charclo/esc-power-epc/frost-esc.stl

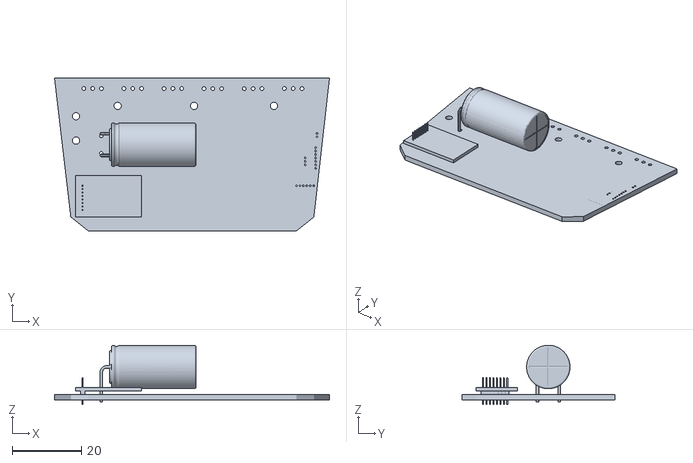
[picture p1: CAD file, 2022-11-25]
frost-esc.stl
79.2 x 44.0 x 17.1
