charclo/esc-power-epc/images/ESC-power-epc.pdf

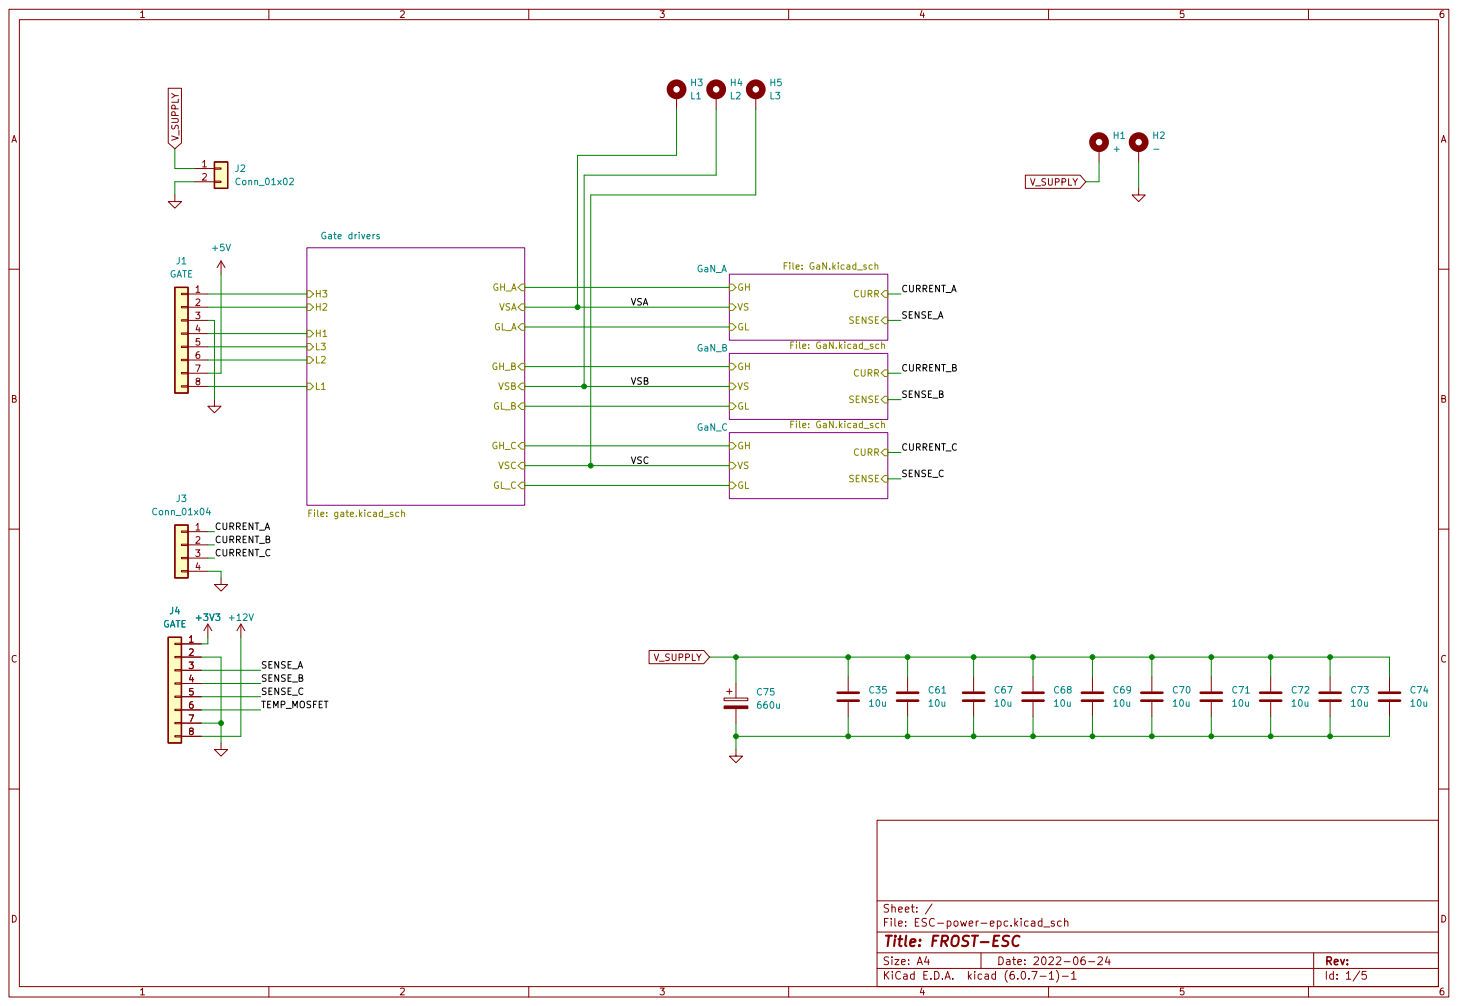
[picture p2: page 1]

VSA

File: ESC-power-epc.kicad_sch Sheet: /
Id: 1/5 Title: FROST-ESC

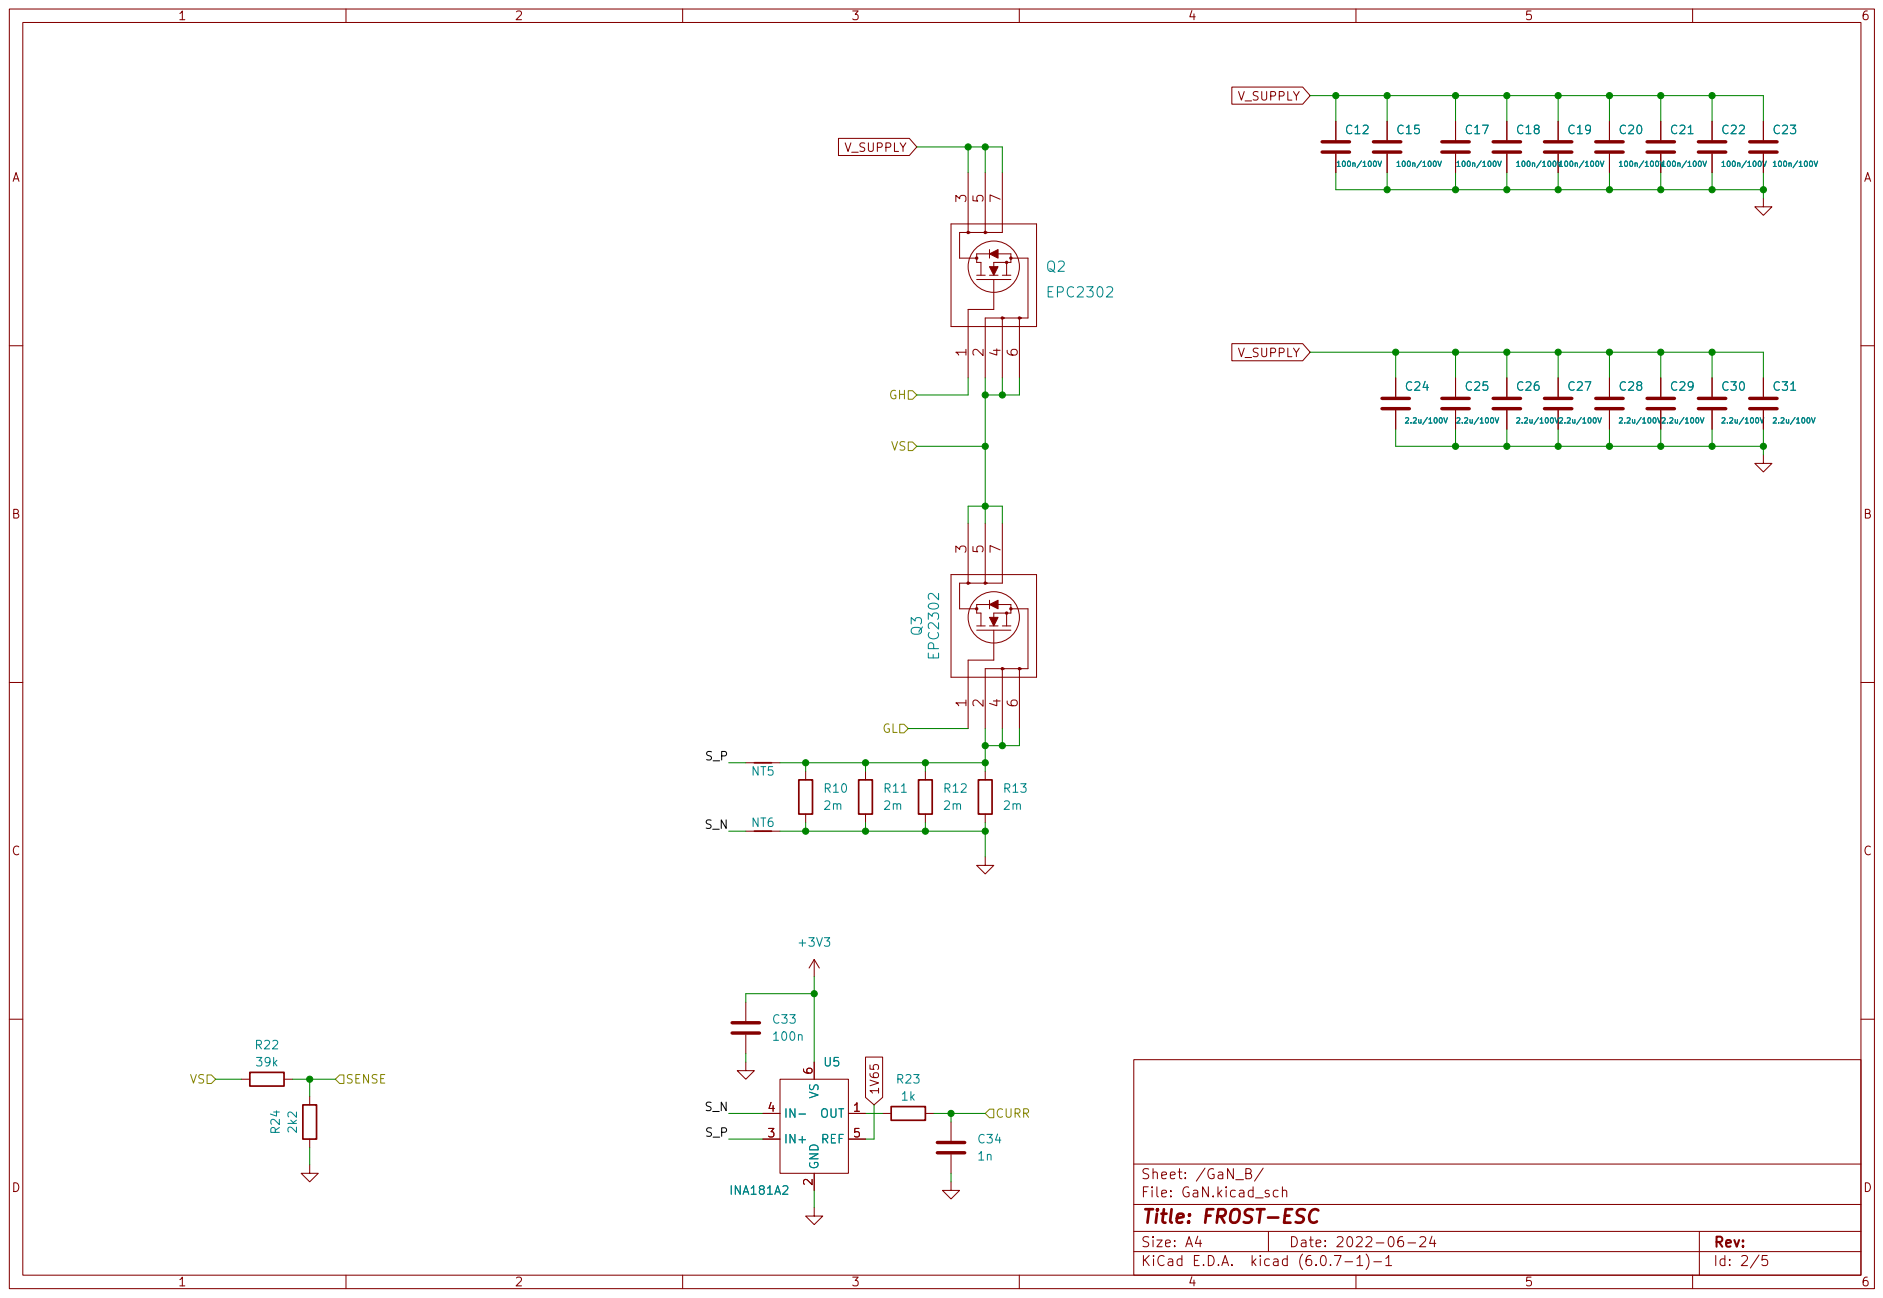
[picture p3: page 2]

File: GaN.kicad_sch
Id: 2/5 Title: FROST-ESC

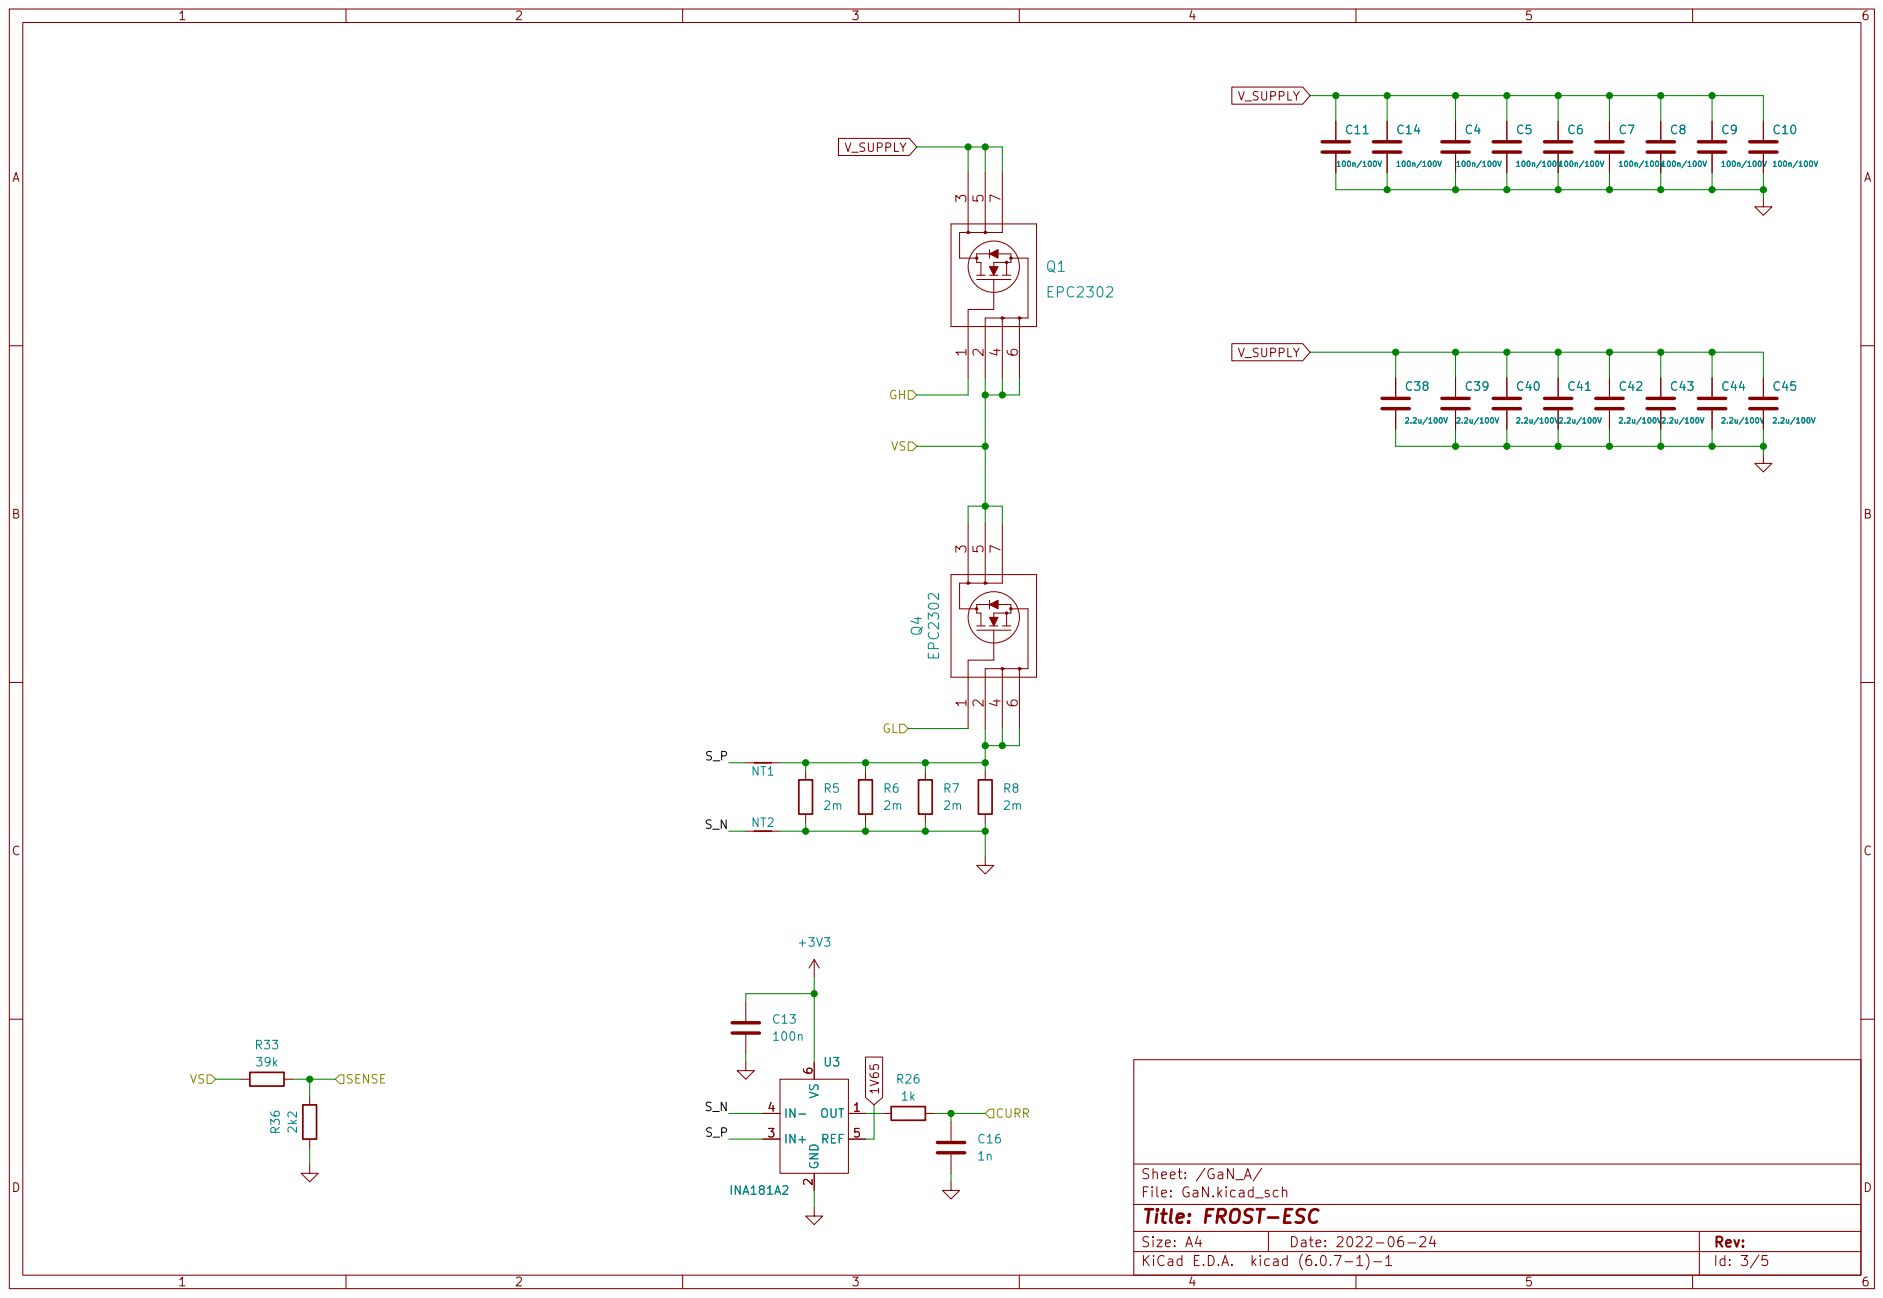
[picture p4: page 3]

File: GaN.kicad_sch
Id: 3/5 Title: FROST-ESC

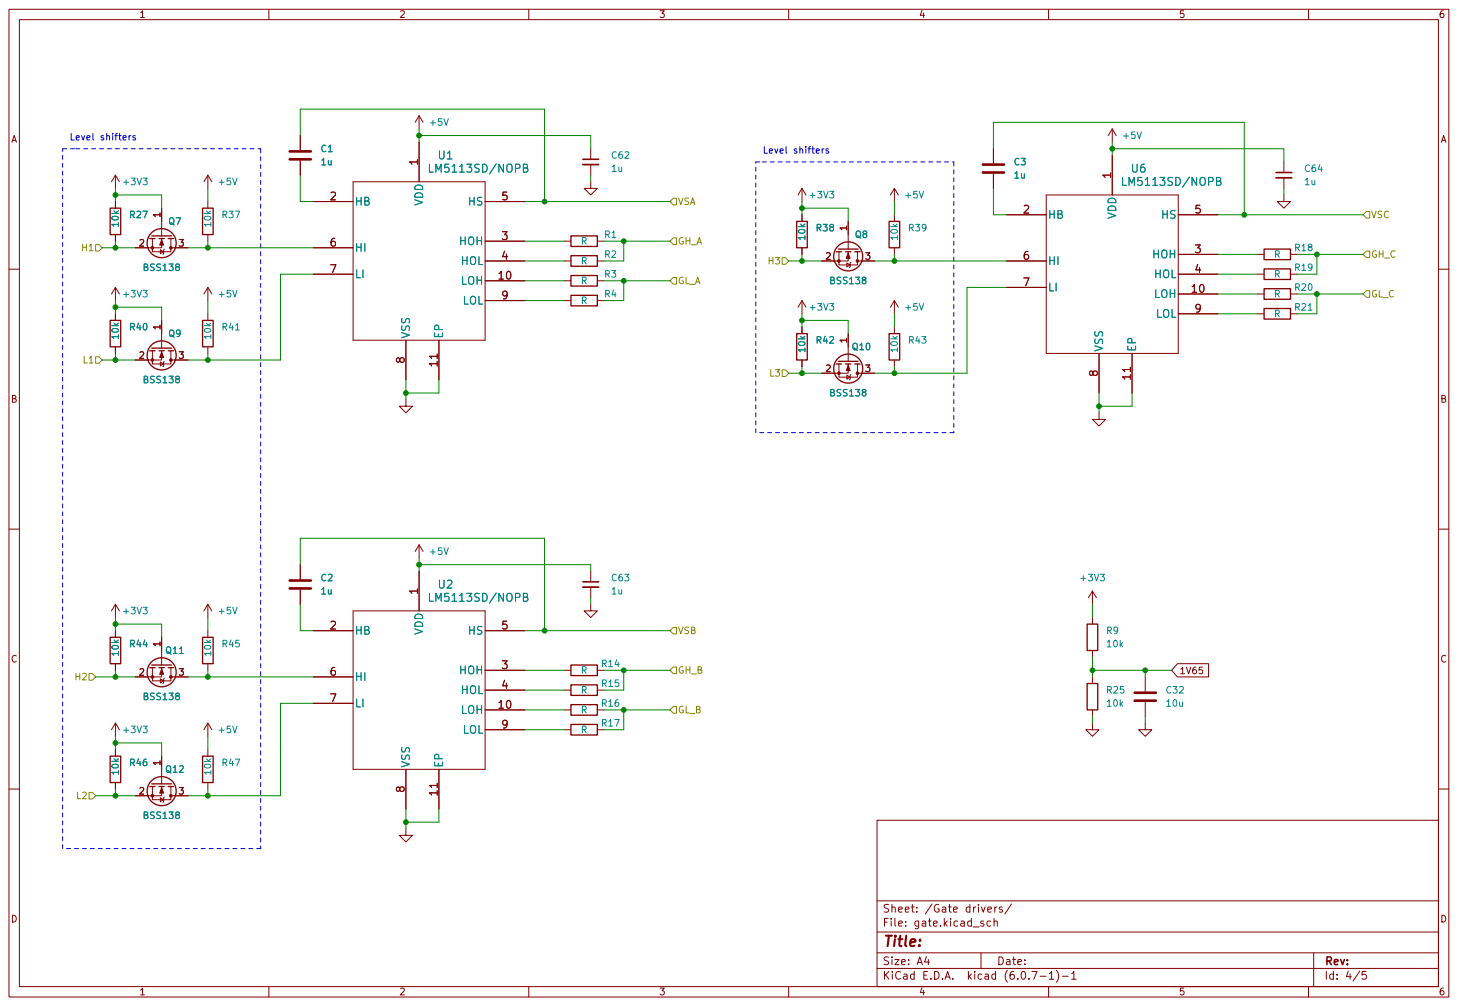
[picture p5: page 4]

File: gate.kicad_sch Sheet: /Gate drivers/
Id: 4/5 Title:

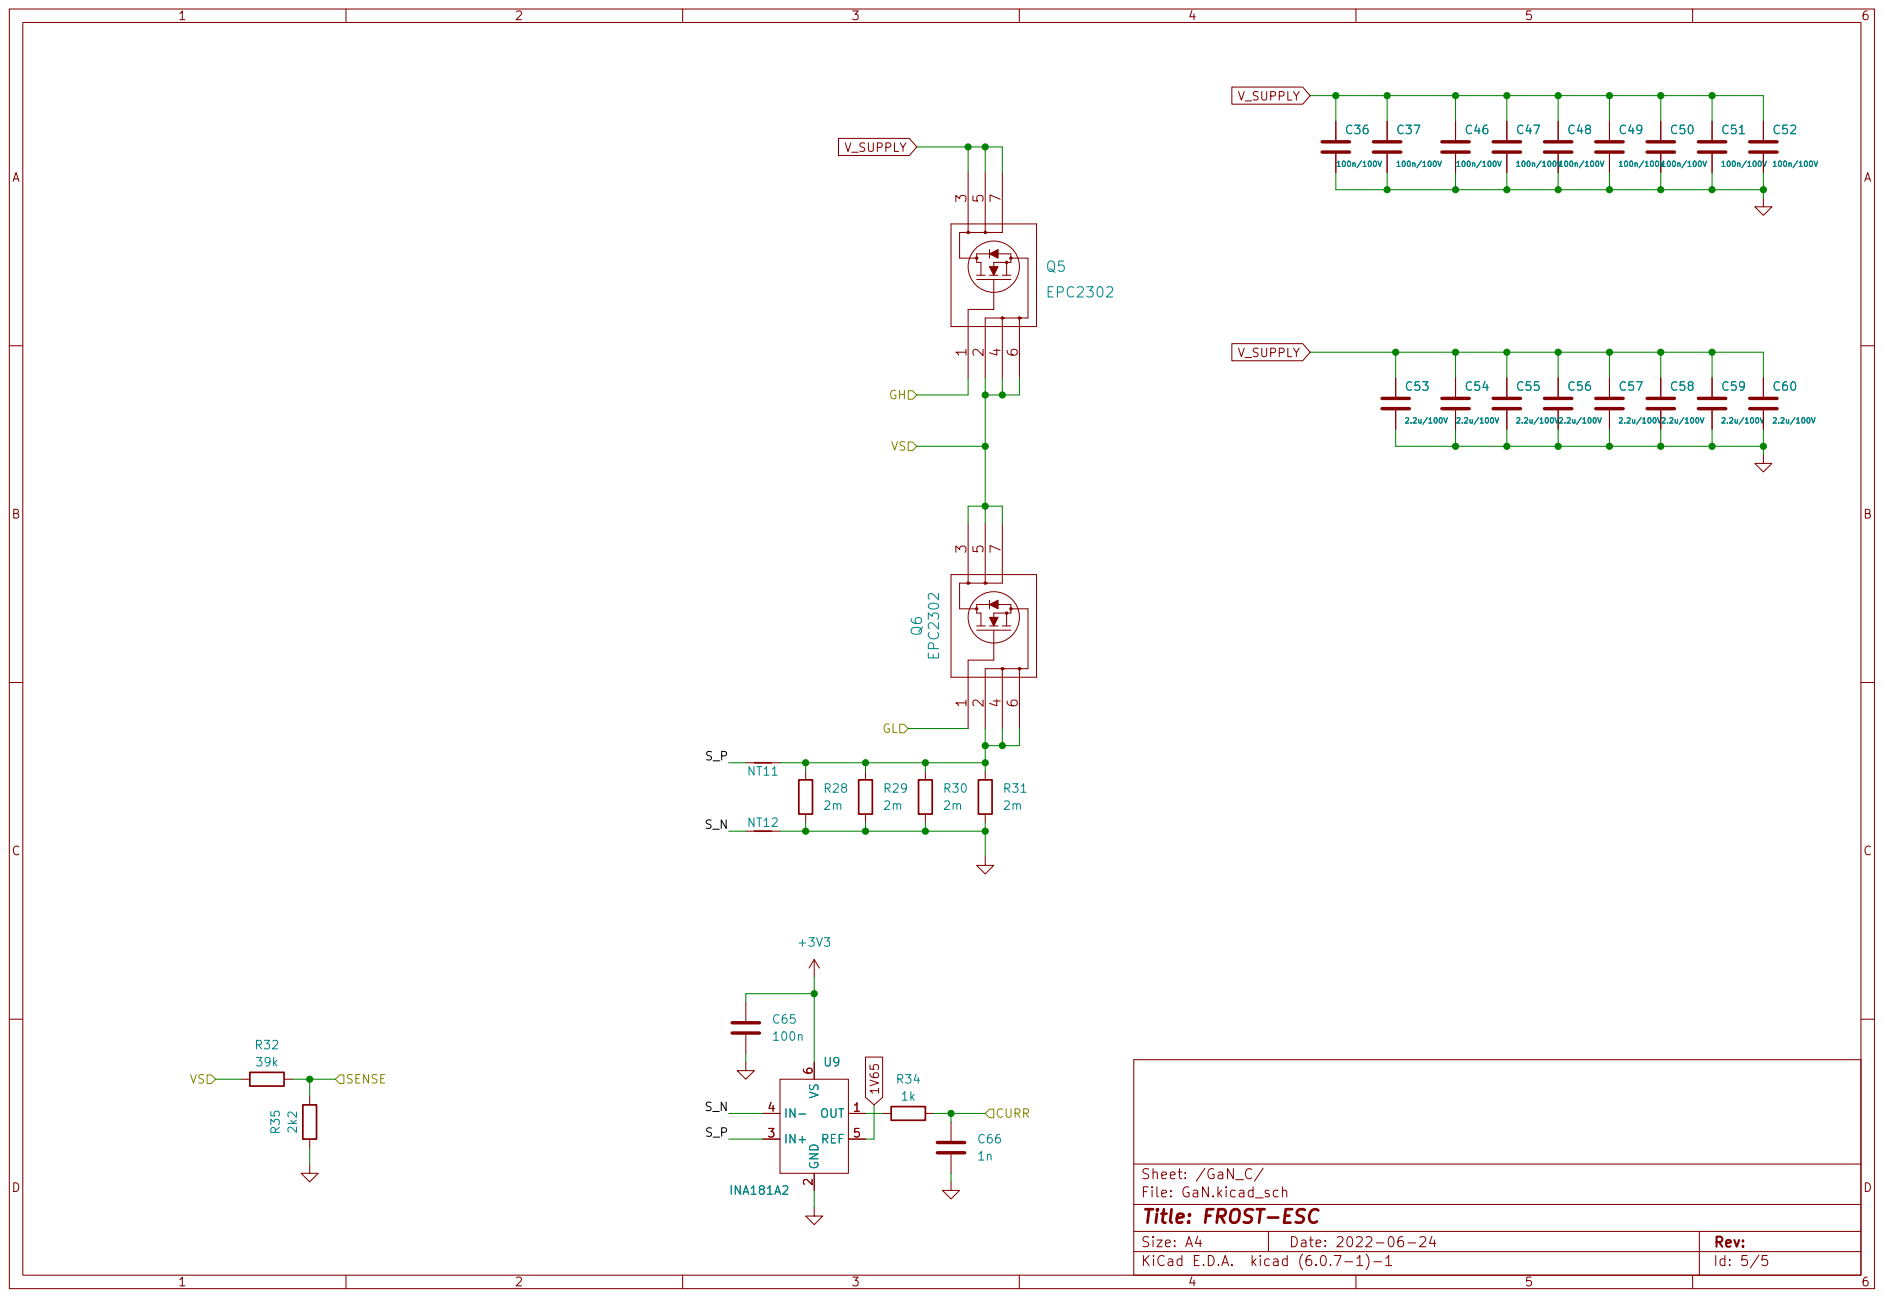
[picture p6: page 5]

File: GaN.kicad_sch
Id: 5/5 Title: FROST-ESC
