charclo/esc-power-epc/ESC-power-epc.kicad_pcb

## KiCad design ESC-power-epc.kicad_pcb (2023-02-20)

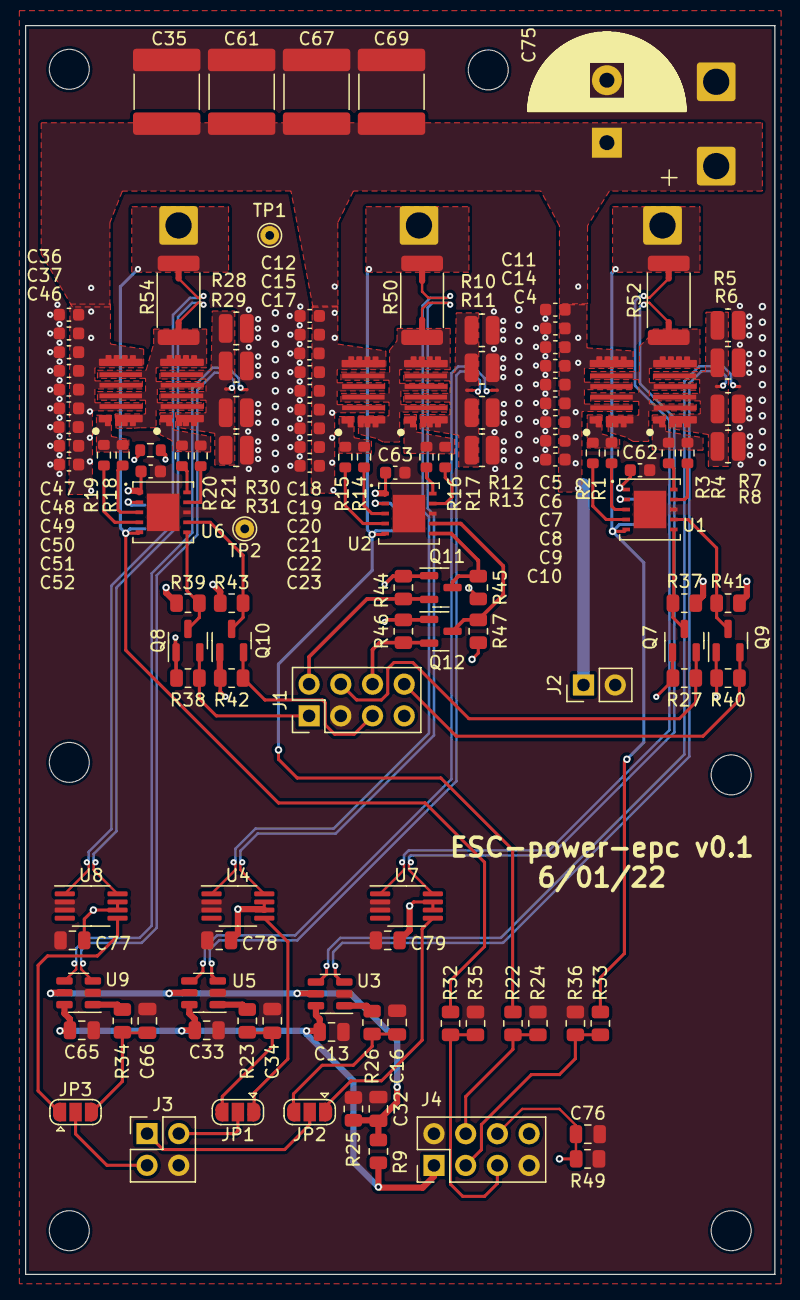
[picture p7: board ESC-power-epc.kicad_pcb from above]

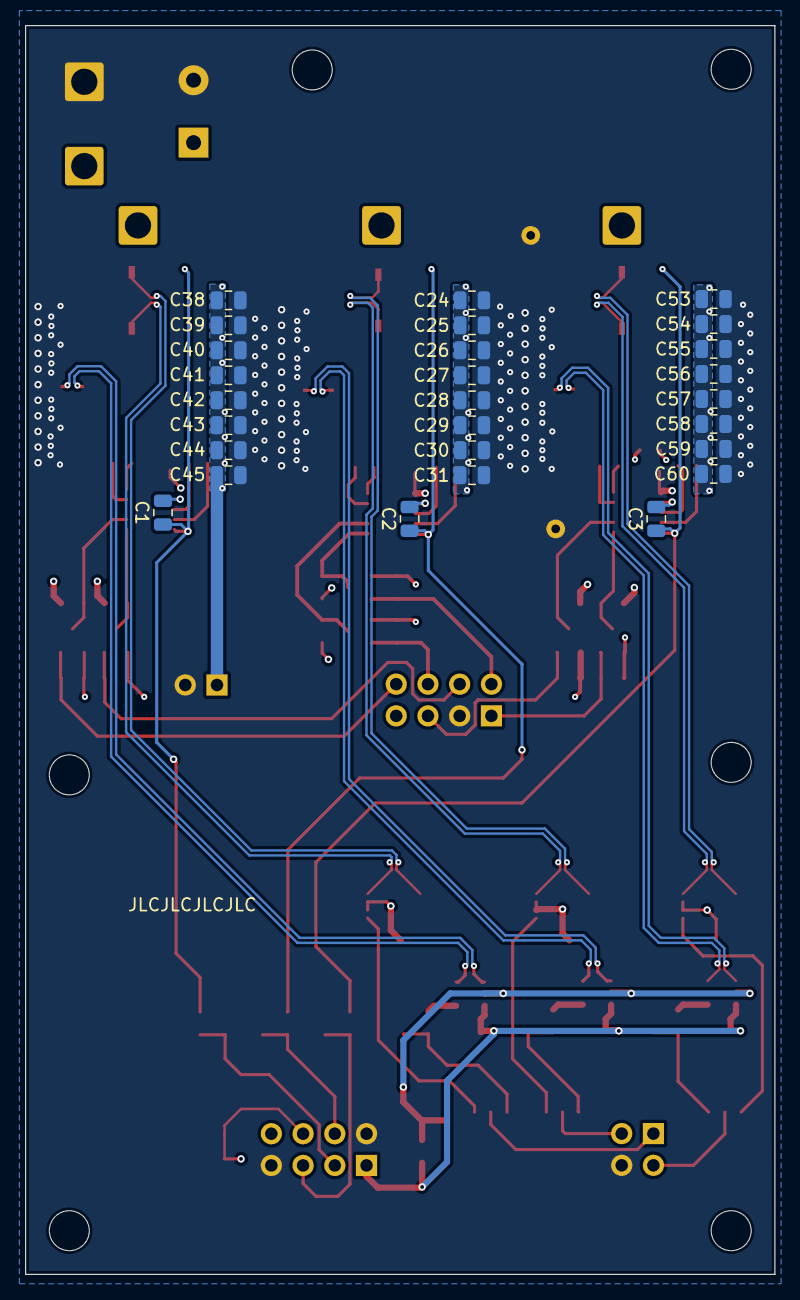
[picture p8: board ESC-power-epc.kicad_pcb from below]

Board: 4 copper layers, 60.0 x 100.0 mm, 178 parts (27 on the bottom side), 75 nets.

Parts:
C1, C2, C3: 1u; C_0805_2012Metric
C4, C5, C6, C7, C8, C9, C10, C11, C12, C14, C15, C17, C18, C19, C20, C21, C22, C23, C36, C37, C46, C47, C48, C49, C50, C51, C52: 100n/100V; C_0603_1608Metric
C13, C33, C65: 100n; C_0805_2012Metric
C16, C34, C66: 1n; C_0805_2012Metric
C24, C25, C26, C27, C28, C29, C30, C31, C38, C39, C40, C41, C42, C43, C44, C45, C53, C54, C55, C56, C57, C58, C59, C60: 2.2u/100V; C_0805_2012Metric
C32: 10u; C_0805_2012Metric
C35, C61, C67, C69: 10u/100V; C_2220_5650Metric
C62, C63, C64: 1u; C_0603_1608Metric
C75: 660u; CP_Radial_D12.5mm_P5.00mm
C76, C77, C78, C79: 2u2; C_0805_2012Metric
H1: +; SolderWire-1.5sqmm_1x01_D1.7mm_OD3mm
H2: -; SolderWire-1.5sqmm_1x01_D1.7mm_OD3mm
H3: L1; SolderWire-1.5sqmm_1x01_D1.7mm_OD3mm
H4: L2; SolderWire-1.5sqmm_1x01_D1.7mm_OD3mm
H5: L3; SolderWire-1.5sqmm_1x01_D1.7mm_OD3mm
H6, H7, H8, H9, H10, H11: MountingHole; MountingHole_3.2mm_M3
J1, J4: GATE; PinHeader_2x04_P2.54mm_Vertical
J2: Conn_01x02; PinHeader_1x02_P2.54mm_Vertical
J3: Conn_01x04; PinHeader_2x02_P2.54mm_Vertical
JP1, JP2, JP3: Jumper_3_Bridged12; SolderJumper-3_P1.3mm_Open_RoundedPad1.0x1.5mm
NT1, NT2, NT5, NT6, NT11, NT12: NetTie_2; NetTie-2_SMD_Pad0.26mm
NT3, NT4, NT7, NT8, NT9, NT10: NetTie_2; NetTie-2_SMD_Pad0.5mm
Q1, Q2, Q3, Q4, Q5, Q6: EPC2302
Q7, Q8, Q9, Q10, Q11, Q12: BSS138; SOT-23
R1, R2, R3, R4, R14, R15, R16, R17, R18, R19, R20, R21: 10; R_0603_1608Metric
R5, R6, R7, R8, R10, R11, R12, R13, R28, R29, R30, R31: 2m; 0805W
R9, R25, R27, R37, R38, R39, R40, R41, R42, R43, R44, R45, R46, R47, R49: 10k; R_0805_2012Metric
R22, R32, R33: 39k; R_0805_2012Metric
R23, R26, R34: 1k; R_0805_2012Metric
R24, R35, R36: 2k2; R_0805_2012Metric
R48: NTC 10k; R_0603_1608Metric
R50, R52, R54: 1m; R_2512_6332Metric
TP1, TP2: GND; TestPoint_THTPad_D1.5mm_Drill0.7mm
U1, U2, U6: LM5113SD/NOPB; LM5113SD_NOPB
U3, U5, U9: INA181A2; SOT-23-6
U4, U7, U8: AD8418; MSOP-8_3x3mm_P0.65mm

Connections:
1V65: C32.1, R9.2, R25.1, U3.5 (REF), U5.5 (REF), U9.5 (REF)
+3V3: C13.1, C33.1, C65.1, C77.1, C78.1, C79.1, J4.1, Q7.1 (G), Q8.1 (G), Q9.1 (G), Q10.1 (G), Q11.1 (G), Q12.1 (G), R9.1, R27.1, R38.1, R40.1, R42.1, R44.1, R46.1, R48.1, U3.6 (VS), U4.6 (VS), U4.7 (REF1), U5.6 (VS), U7.6 (VS), U7.7 (REF1), U8.6 (VS), U8.7 (REF1), U9.6 (VS)
+5V: C62.1, C63.1, C64.1, J1.7, R37.1, R39.1, R41.1, R43.1, R45.1, R47.1, U1.1 (VDD), U2.1 (VDD), U6.1 (VDD)
/CURRENT_A: J3.1, JP2.2 (C)
/CURRENT_B: J3.2, JP1.2 (C)
/CURRENT_C: J3.3, JP3.2 (C)
/GaN_A/CUR_SHUNT_LOW: C16.1, JP2.3 (B), R26.2
/GaN_A/CUR_SHUNT_PHASE: JP2.1 (A), U7.5 (OUT)
/GaN_A/GH: Q1.1, R1.2, R2.2
/GaN_A/GL: Q4.1, R3.2, R4.2
/GaN_A/IN+: NT8.1, U7.8 (IN+)
/GaN_A/IN-: NT7.1, U7.1 (IN-)
/GaN_A/S_N: NT2.1, U3.4 (IN-)
/GaN_A/S_P: NT1.1, U3.3 (IN+)
/GaN_B/CUR_SHUNT_LOW: C34.1, JP1.3 (B), R23.2
/GaN_B/CUR_SHUNT_PHASE: JP1.1 (A), U4.5 (OUT)
/GaN_B/GH: Q2.1, R14.2, R15.2
/GaN_B/GL: Q3.1, R16.2, R17.2
/GaN_B/IN+: NT4.1, U4.8 (IN+)
/GaN_B/IN-: NT3.1, U4.1 (IN-)
/GaN_B/S_N: NT6.1, U5.4 (IN-)
/GaN_B/S_P: NT5.1, U5.3 (IN+)
/GaN_C/CUR_SHUNT_LOW: C66.1, JP3.3 (B), R34.2
/GaN_C/CUR_SHUNT_PHASE: JP3.1 (A), U8.5 (OUT)
/GaN_C/GH: Q5.1, R18.2, R19.2
/GaN_C/GL: Q6.1, R20.2, R21.2
/GaN_C/IN+: NT10.1, U8.8 (IN+)
/GaN_C/IN-: NT9.1, U8.1 (IN-)
/GaN_C/S_N: NT12.1, U9.4 (IN-)
/GaN_C/S_P: NT11.1, U9.3 (IN+)
/Gate drivers/H1: J1.4, Q7.2 (S), R27.2
/Gate drivers/H2: J1.2, Q11.2 (S), R44.2
/Gate drivers/H3: J1.1, Q8.2 (S), R38.2
/Gate drivers/L1: J1.8, Q9.2 (S), R40.2
/Gate drivers/L2: J1.6, Q12.2 (S), R46.2
/Gate drivers/L3: J1.5, Q10.2 (S), R42.2
/SENSE_A: J4.3, R33.2, R36.2
/SENSE_B: J4.4, R22.2, R24.2
/SENSE_C: J4.5, R32.2, R35.2
/TEMP_FET: C76.1, J4.6, R48.2, R49.1
/VSA: C1.1, H3.1, NT7.2, R33.1, R52.1, U1.5 (HS)
/VSB: C2.1, H4.1, NT3.2, R22.1, R50.1, U2.5 (HS)
/VSC: C3.1, H5.1, NT9.2, R32.1, R54.1, U6.5 (HS)
GND: C4.2, C5.2, C6.2, C7.2, C8.2, C9.2, C10.2, C11.2, C12.2, C13.2, C14.2, C15.2, C16.2, C17.2, C18.2, C19.2, C20.2, C21.2, C22.2, C23.2, C24.2, C25.2, C26.2, C27.2, C28.2, C29.2, C30.2, C31.2, C32.2, C33.2, C34.2, C35.2, C36.2, C37.2, C38.2, C39.2, C40.2, C41.2, C42.2, C43.2, C44.2, C45.2, C46.2, C47.2, C48.2, C49.2, C50.2, C51.2, C52.2, C53.2, C54.2, C55.2, C56.2, C57.2, C58.2, C59.2, C60.2, C61.2, C62.2, C63.2, C64.2, C65.2, C66.2, C67.2, C69.2, C75.2, C76.2, C77.2, C78.2, C79.2, H2.1, J1.3, J2.2, J3.4, J4.2, J4.7, NT2.2, NT6.2, NT12.2, R5.2, R6.2, R7.2, R8.2, R10.2, R11.2, R12.2, R13.2, R24.1, R25.2, R28.2, R29.2, R30.2, R31.2, R35.1, R36.1, R49.2, TP1.1, TP2.1, U1.8 (VSS), U1.11 (EP), U2.8 (VSS), U2.11 (EP), U3.2 (GND), U4.2 (GND), U4.3 (REF2), U5.2 (GND), U6.8 (VSS), U6.11 (EP), U7.2 (GND), U7.3 (REF2), U8.2 (GND), U8.3 (REF2), U9.2 (GND)
unnamed: C1.2, U1.2 (HB)
unnamed: C2.2, U2.2 (HB)
unnamed: C3.2, U6.2 (HB)
unnamed: NT1.2, Q4.2, Q4.4, Q4.6, R5.1, R6.1, R7.1, R8.1
unnamed: NT4.2, Q2.2, Q2.4, Q2.6, Q3.3, Q3.5, Q3.7, R50.2
unnamed: NT5.2, Q3.2, Q3.4, Q3.6, R10.1, R11.1, R12.1, R13.1
unnamed: NT8.2, Q1.2, Q1.4, Q1.6, Q4.3, Q4.5, Q4.7, R52.2
unnamed: NT10.2, Q5.2, Q5.4, Q5.6, Q6.3, Q6.5, Q6.7, R54.2
unnamed: NT11.2, Q6.2, Q6.4, Q6.6, R28.1, R29.1, R30.1, R31.1
unnamed: Q7.3 (D), R37.2, U1.6 (HI)
unnamed: Q8.3 (D), R39.2, U6.6 (HI)
unnamed: Q9.3 (D), R41.2, U1.7 (LI)
unnamed: Q10.3 (D), R43.2, U6.7 (LI)
unnamed: Q11.3 (D), R45.2, U2.6 (HI)
unnamed: Q12.3 (D), R47.2, U2.7 (LI)
unnamed: R1.1, U1.3 (HOH)
unnamed: R2.1, U1.4 (HOL)
unnamed: R3.1, U1.10 (LOH)
unnamed: R4.1, U1.9 (LOL)
unnamed: R14.1, U2.3 (HOH)
unnamed: R15.1, U2.4 (HOL)
unnamed: R16.1, U2.10 (LOH)
unnamed: R17.1, U2.9 (LOL)
unnamed: R18.1, U6.3 (HOH)
unnamed: R19.1, U6.4 (HOL)
unnamed: R20.1, U6.10 (LOH)
unnamed: R21.1, U6.9 (LOL)
unnamed: R23.1, U5.1 (OUT)
unnamed: R26.1, U3.1 (OUT)
unnamed: R34.1, U9.1 (OUT)
V_SUPPLY: C4.1, C5.1, C6.1, C7.1, C8.1, C9.1, C10.1, C11.1, C12.1, C14.1, C15.1, C17.1, C18.1, C19.1, C20.1, C21.1, C22.1, C23.1, C24.1, C25.1, C26.1, C27.1, C28.1, C29.1, C30.1, C31.1, C35.1, C36.1, C37.1, C38.1, C39.1, C40.1, C41.1, C42.1, C43.1, C44.1, C45.1, C46.1, C47.1, C48.1, C49.1, C50.1, C51.1, C52.1, C53.1, C54.1, C55.1, C56.1, C57.1, C58.1, C59.1, C60.1, C61.1, C67.1, C69.1, C75.1, H1.1, J2.1, Q1.3, Q1.5, Q1.7, Q2.3, Q2.5, Q2.7, Q5.3, Q5.5, Q5.7
