charclo/esc-power-epc/(commit log)

2022-12-05 before changing connector
    [ESC-power-epc.kicad_pcb, ESC-power-epc.kicad_sch, GaN.kicad_sch, gate.kicad_sch]
2022-12-09 before meeting
    [CAN.kicad_sch, DRV8301.kicad_sch, ESC-power-epc.csv, ESC-power-epc.kicad_pcb, ESC-power-epc.kicad_sch, FD6288.kicad_sch, GaN.kicad_sch, MCU.kicad_sch]
